joebmz98/DCLK/assets/DCLK_back_panel_BW_125x63mm_1200dpi.png

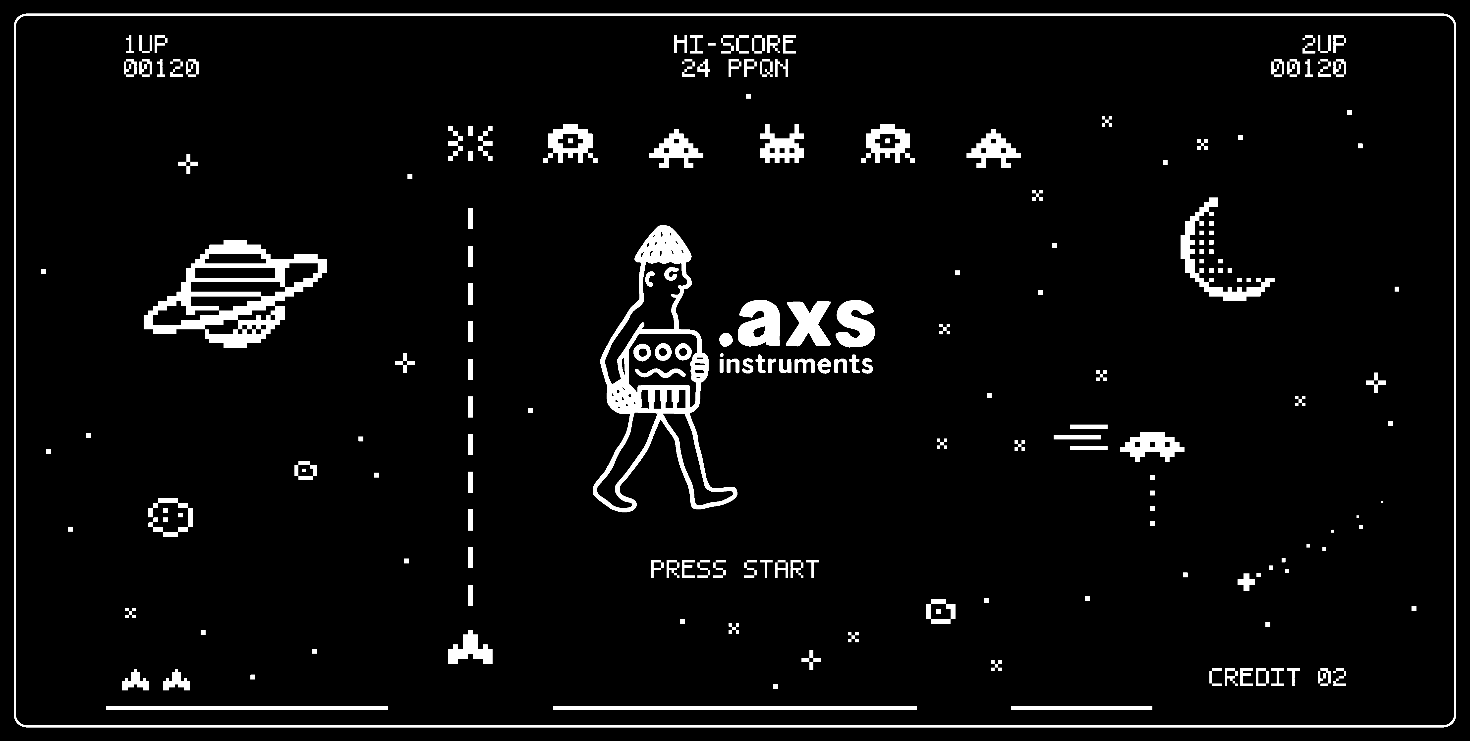
assets/DCLK_back_panel_BW_125x63mm_1200dpi.png
