joebmz98/DCLK/assets/DCLK_panel_BW_125x63mm_1200dpi.png

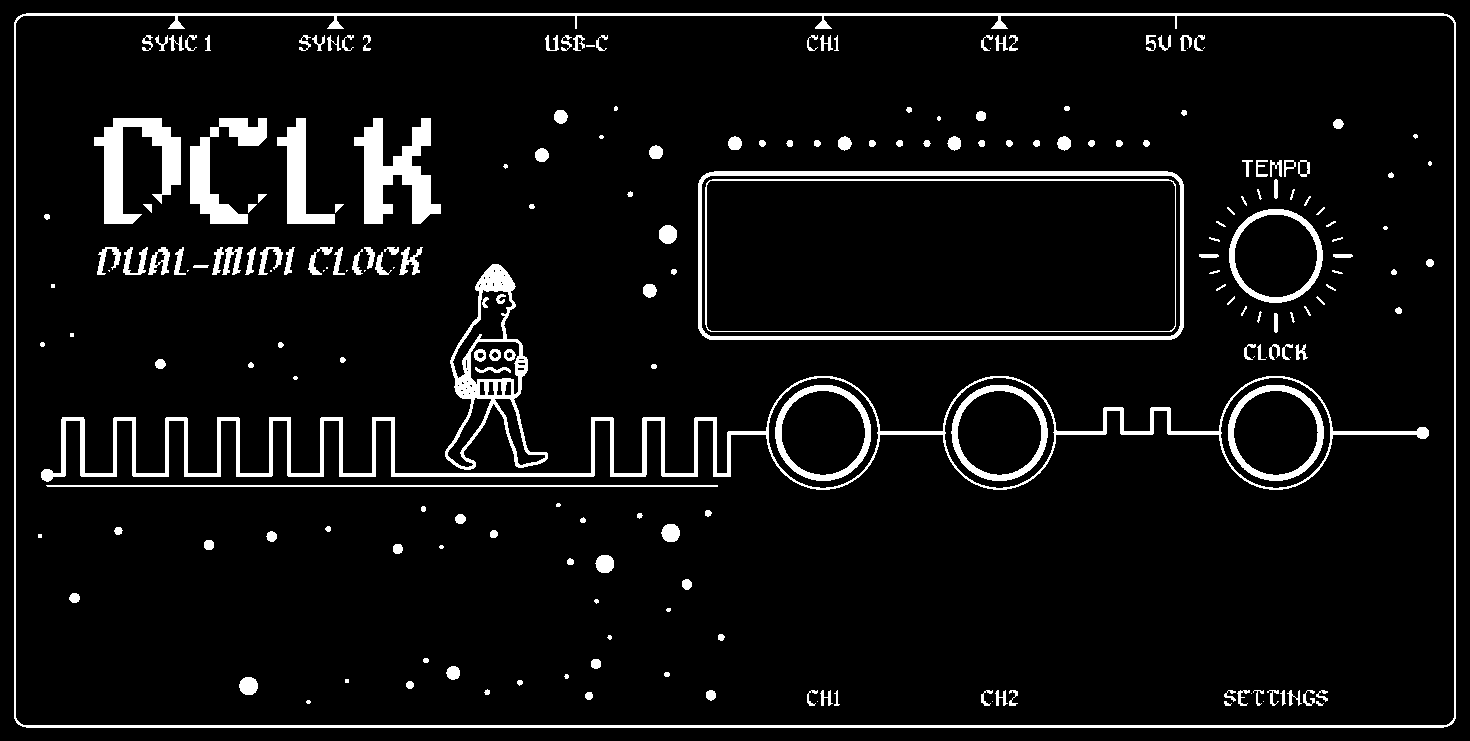
assets/DCLK_panel_BW_125x63mm_1200dpi.png
