joebmz98/DCLK/assets/Images/EDITS/DCLK_1.JPG

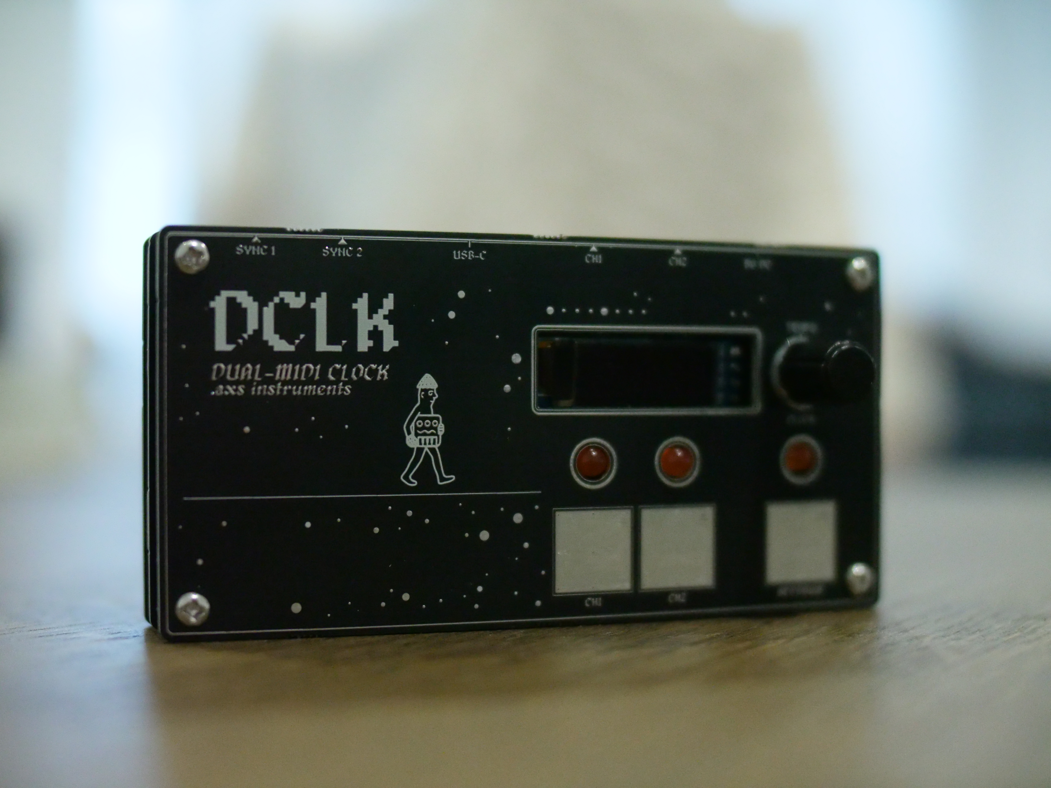
assets/Images/EDITS/DCLK_1.JPG
