joebmz98/DCLK/assets/Images/EDITS/DCLK_2.JPG

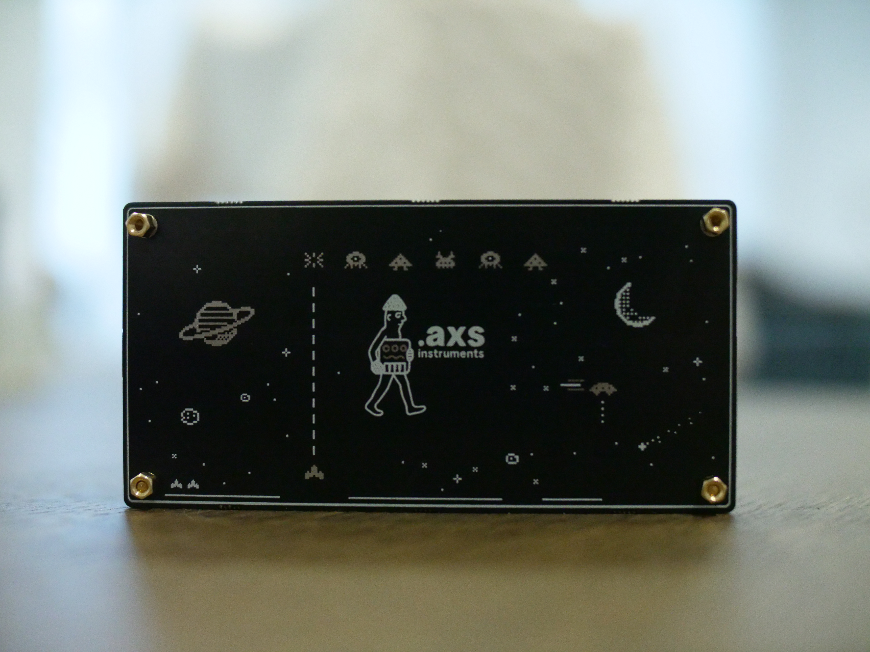
assets/Images/EDITS/DCLK_2.JPG
