joebmz98/DCLK/assets/Images/EDITS/DCLK_3.JPG

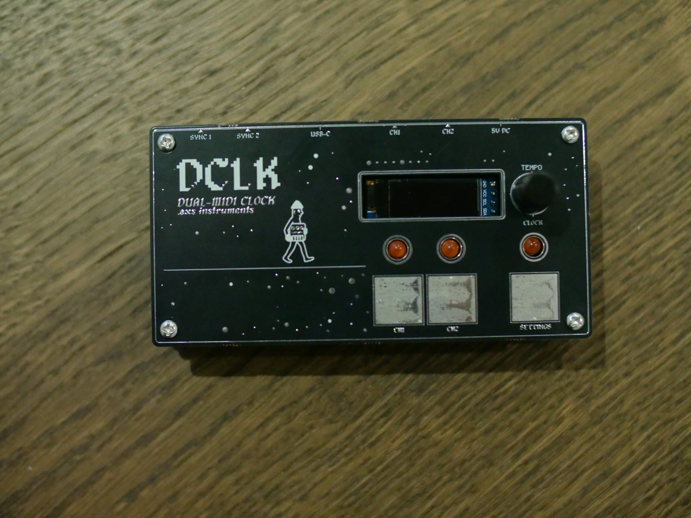
assets/Images/EDITS/DCLK_3.JPG
