joebmz98/DCLK/assets/Images/EDITS/DCLK_4.JPG

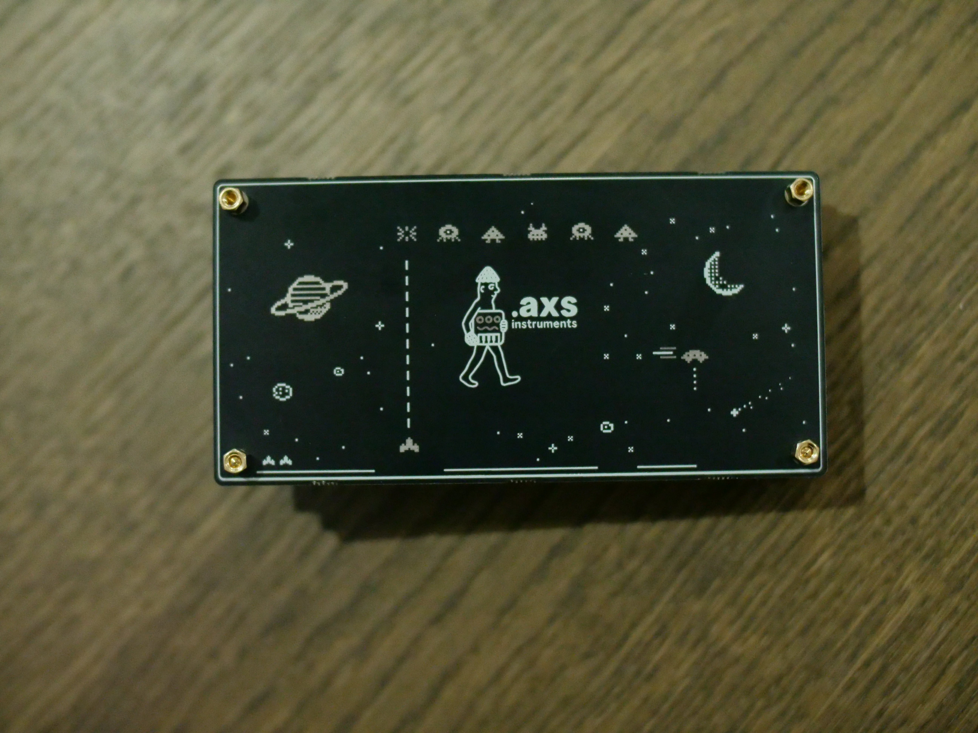
assets/Images/EDITS/DCLK_4.JPG
