joebmz98/DCLK/assets/Images/EDITS/DCLK_5.JPG

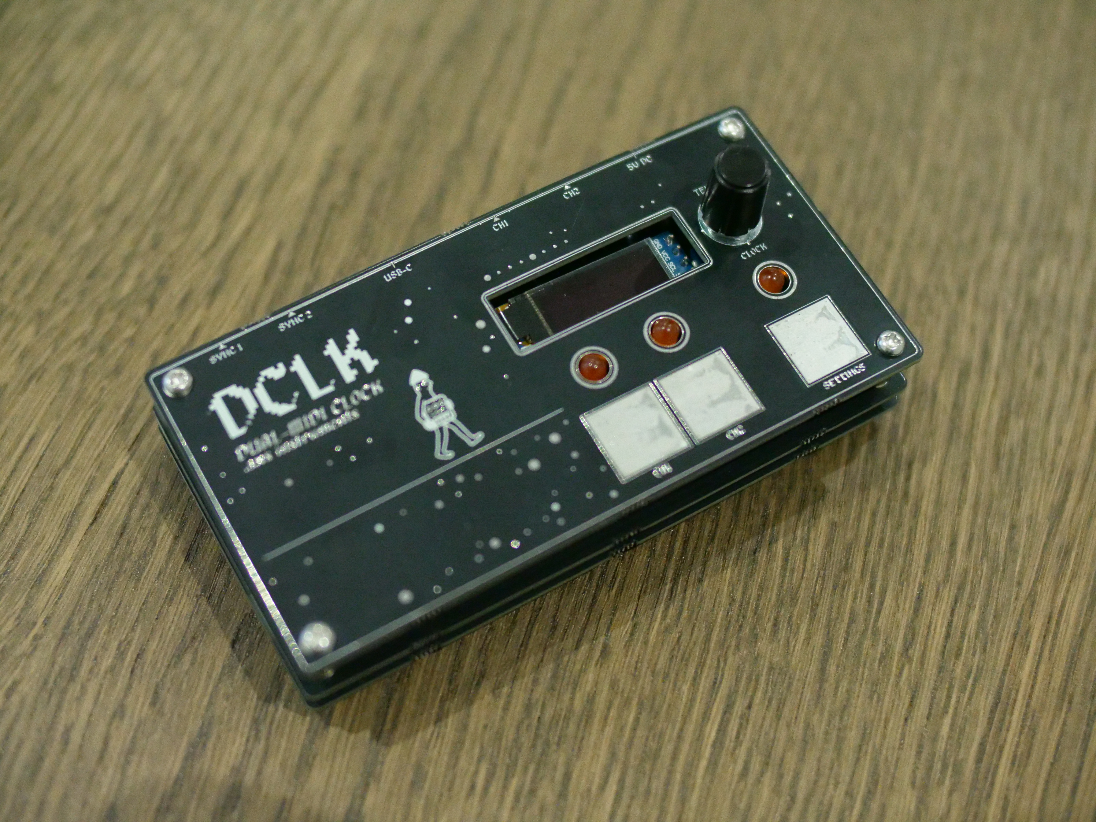
assets/Images/EDITS/DCLK_5.JPG
