joebmz98/DCLK/assets/KiCad Images/DCLK-MIDI-Clock-Schematic.png

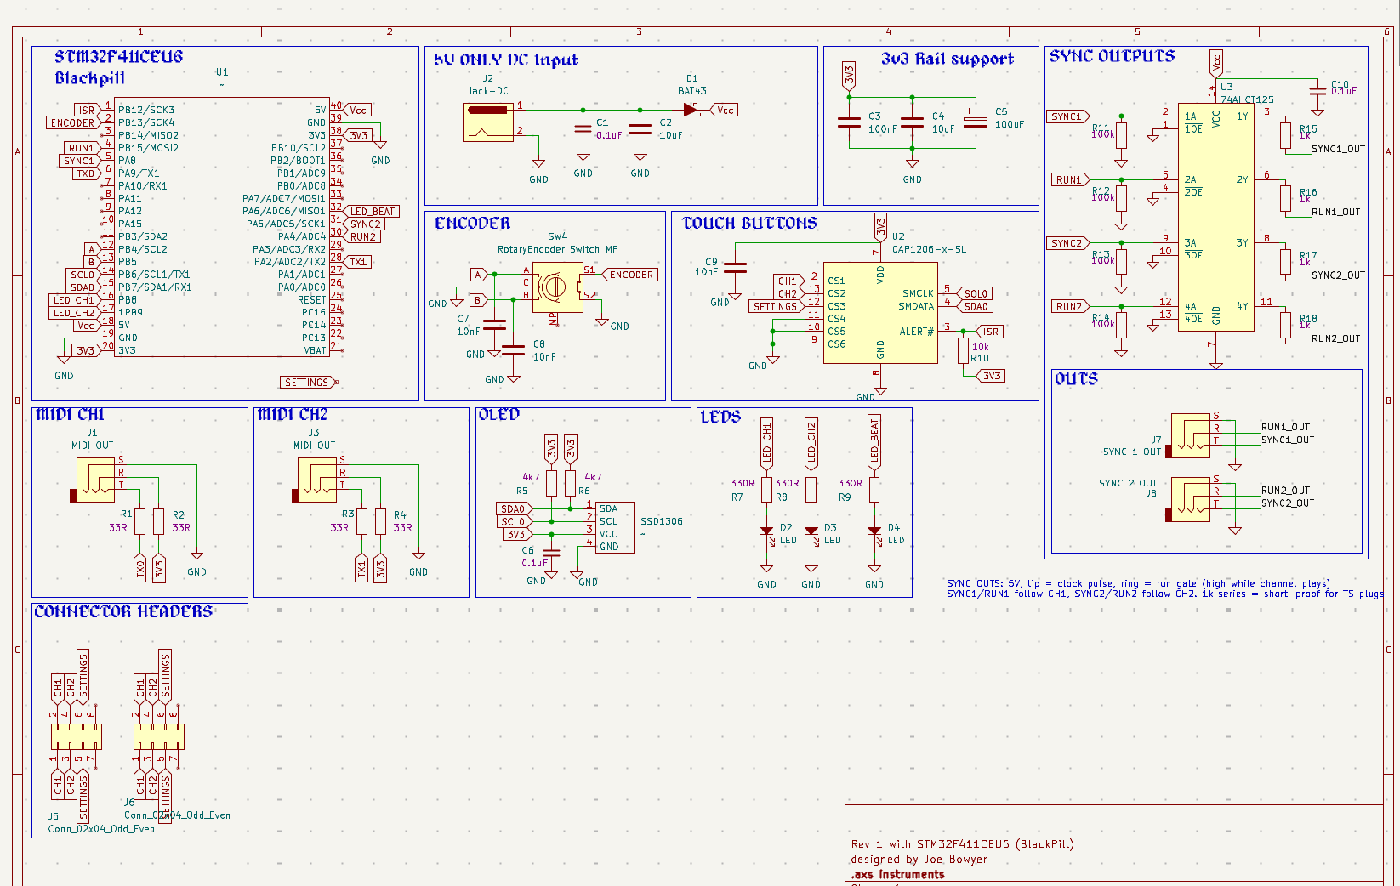
assets/KiCad Images/DCLK-MIDI-Clock-Schematic.png
