joebmz98/DCLK/assets/KiCad Images/DCLK-MIDI-Clock_bottom.png

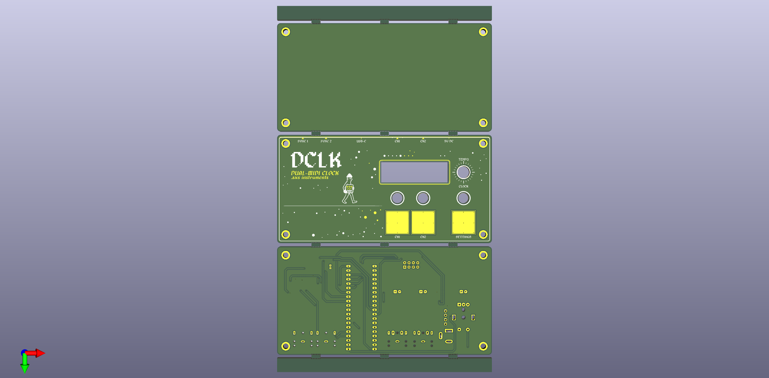
assets/KiCad Images/DCLK-MIDI-Clock_bottom.png
