joebmz98/DCLK/assets/KiCad Images/DCLK-MIDI-Clock_top.png

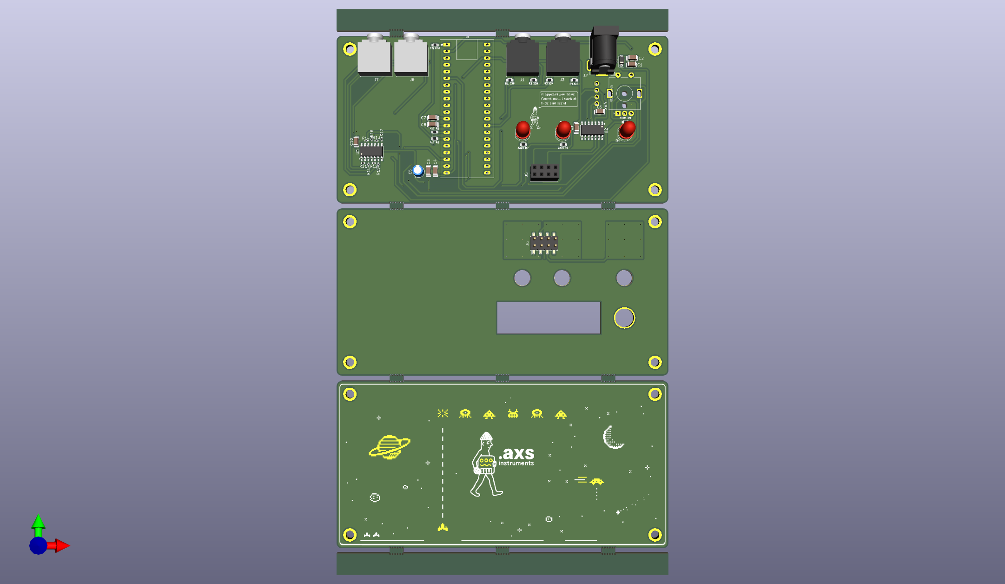
assets/KiCad Images/DCLK-MIDI-Clock_top.png
