joebmz98/DCLK/assets/KiCad Images/Screenshot 2026-10-31 at 09.25.36.png

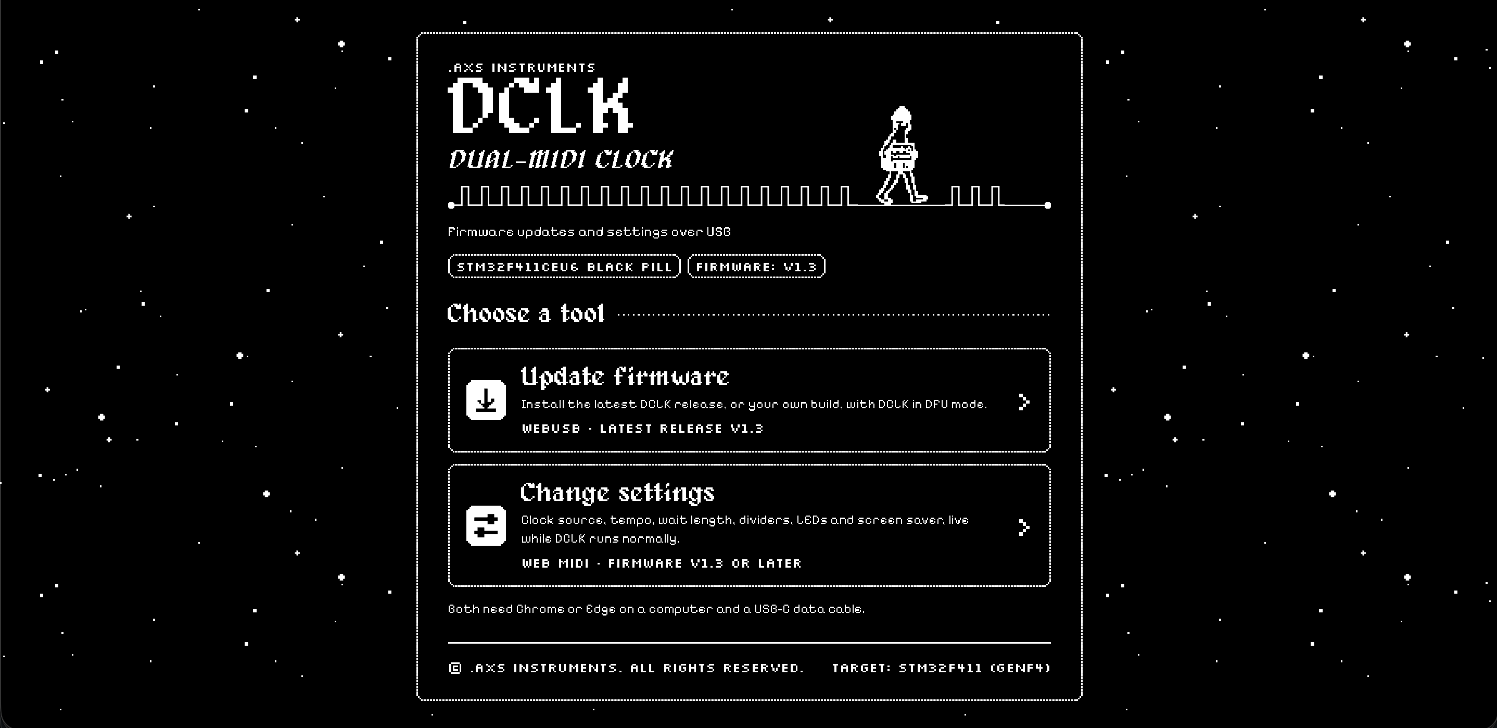
assets/KiCad Images/Screenshot 2026-10-31 at 09.25.36.png
