joebmz98/DCLK/assets/Polarity_marking_center_positive.png

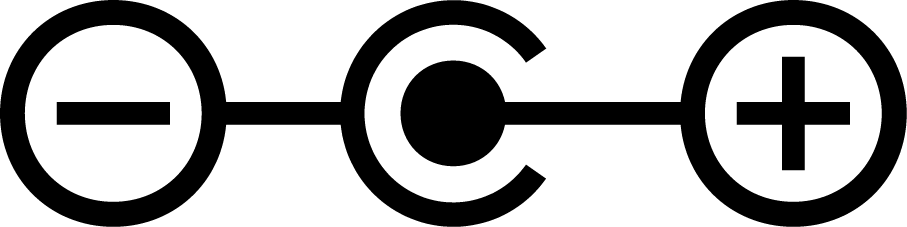
assets/Polarity_marking_center_positive.png
