joebmz98/DCLK/build/DCLK-MIDI-Clock/production/DCLK_bom.csv

Designator | Footprint | Quantity | Value | LCSC Part #
C1, C10, C3, C6 | 1206 | 4 | 100nF | C24497
C2, C4 | 1206 | 2 | 10uF | C13585
C5 | CP_Radial_D4.0mm_P1.50mm | 1 | 100uF
C7, C8, C9 | 1206 | 3 | 10nF | C1846
D1 | D_SOD-123 | 1 | BAT43 | C19167
D2, D3, D4 | LED_D5.0mm | 3 | LED
J1, J3 | Jack_3.5mm_CUI_SJ1-3525N_Horizontal_edit | 2 | MIDI OUT
J2 | BarrelJack_GCT_DCJ200-10-A_Horizontal | 1 | Jack-DC
J5 | PinSocket_2x04_P2.54mm_Vertical | 1 | Conn_02x04_Odd_Even | C54907661
J6 | PinHeader_2x04_P2.54mm_Vertical_SMD | 1 | Conn_02x04_Odd_Even | C41397153
J7 | PJ307-TRS-SOCKET | 1 | SYNC 1 OUT
J8 | PJ307-TRS-SOCKET | 1 | SYNC 2 OUT
R1, R2, R3, R4 | R_0603 | 4 | 33R | C23140
R10 | R_0603 | 1 | 10k | C15401
R11, R12, R13, R14 | 0402 | 4 | 100k | C25530
R15, R16, R17, R18 | 0402 | 4 | 1k | C11702
R5, R6 | R_0603 | 2 | 4k7 | C23162
R7, R8, R9 | R_0603 | 3 | 330R | C22104
SSD1306 | SSD1306-128x32 | 1 | ~
SW4 | RotaryEncoder_Alps_EC11E-Switch_Vertical_H20mm_MountingHoles | 1 | RotaryEncoder_Switch_MP
U1 | Z_module_black_pill_STM32F411 | 1 | ~
U2 | SOIC-14_3.9x8.7mm_P1.27mm | 1 | CAP1206-x-SL | C2652106
U3 | SOIC-14_3.9x8.7mm_P1.27mm | 1 | 74AHCT125 | C155176
