joebmz98/DCLK/build/DCLK-MIDI-Clock/DCLK-MIDI-Clock.kicad_pcb

## KiCad design build/DCLK-MIDI-Clock/DCLK-MIDI-Clock.kicad_pcb (2026-10-29)

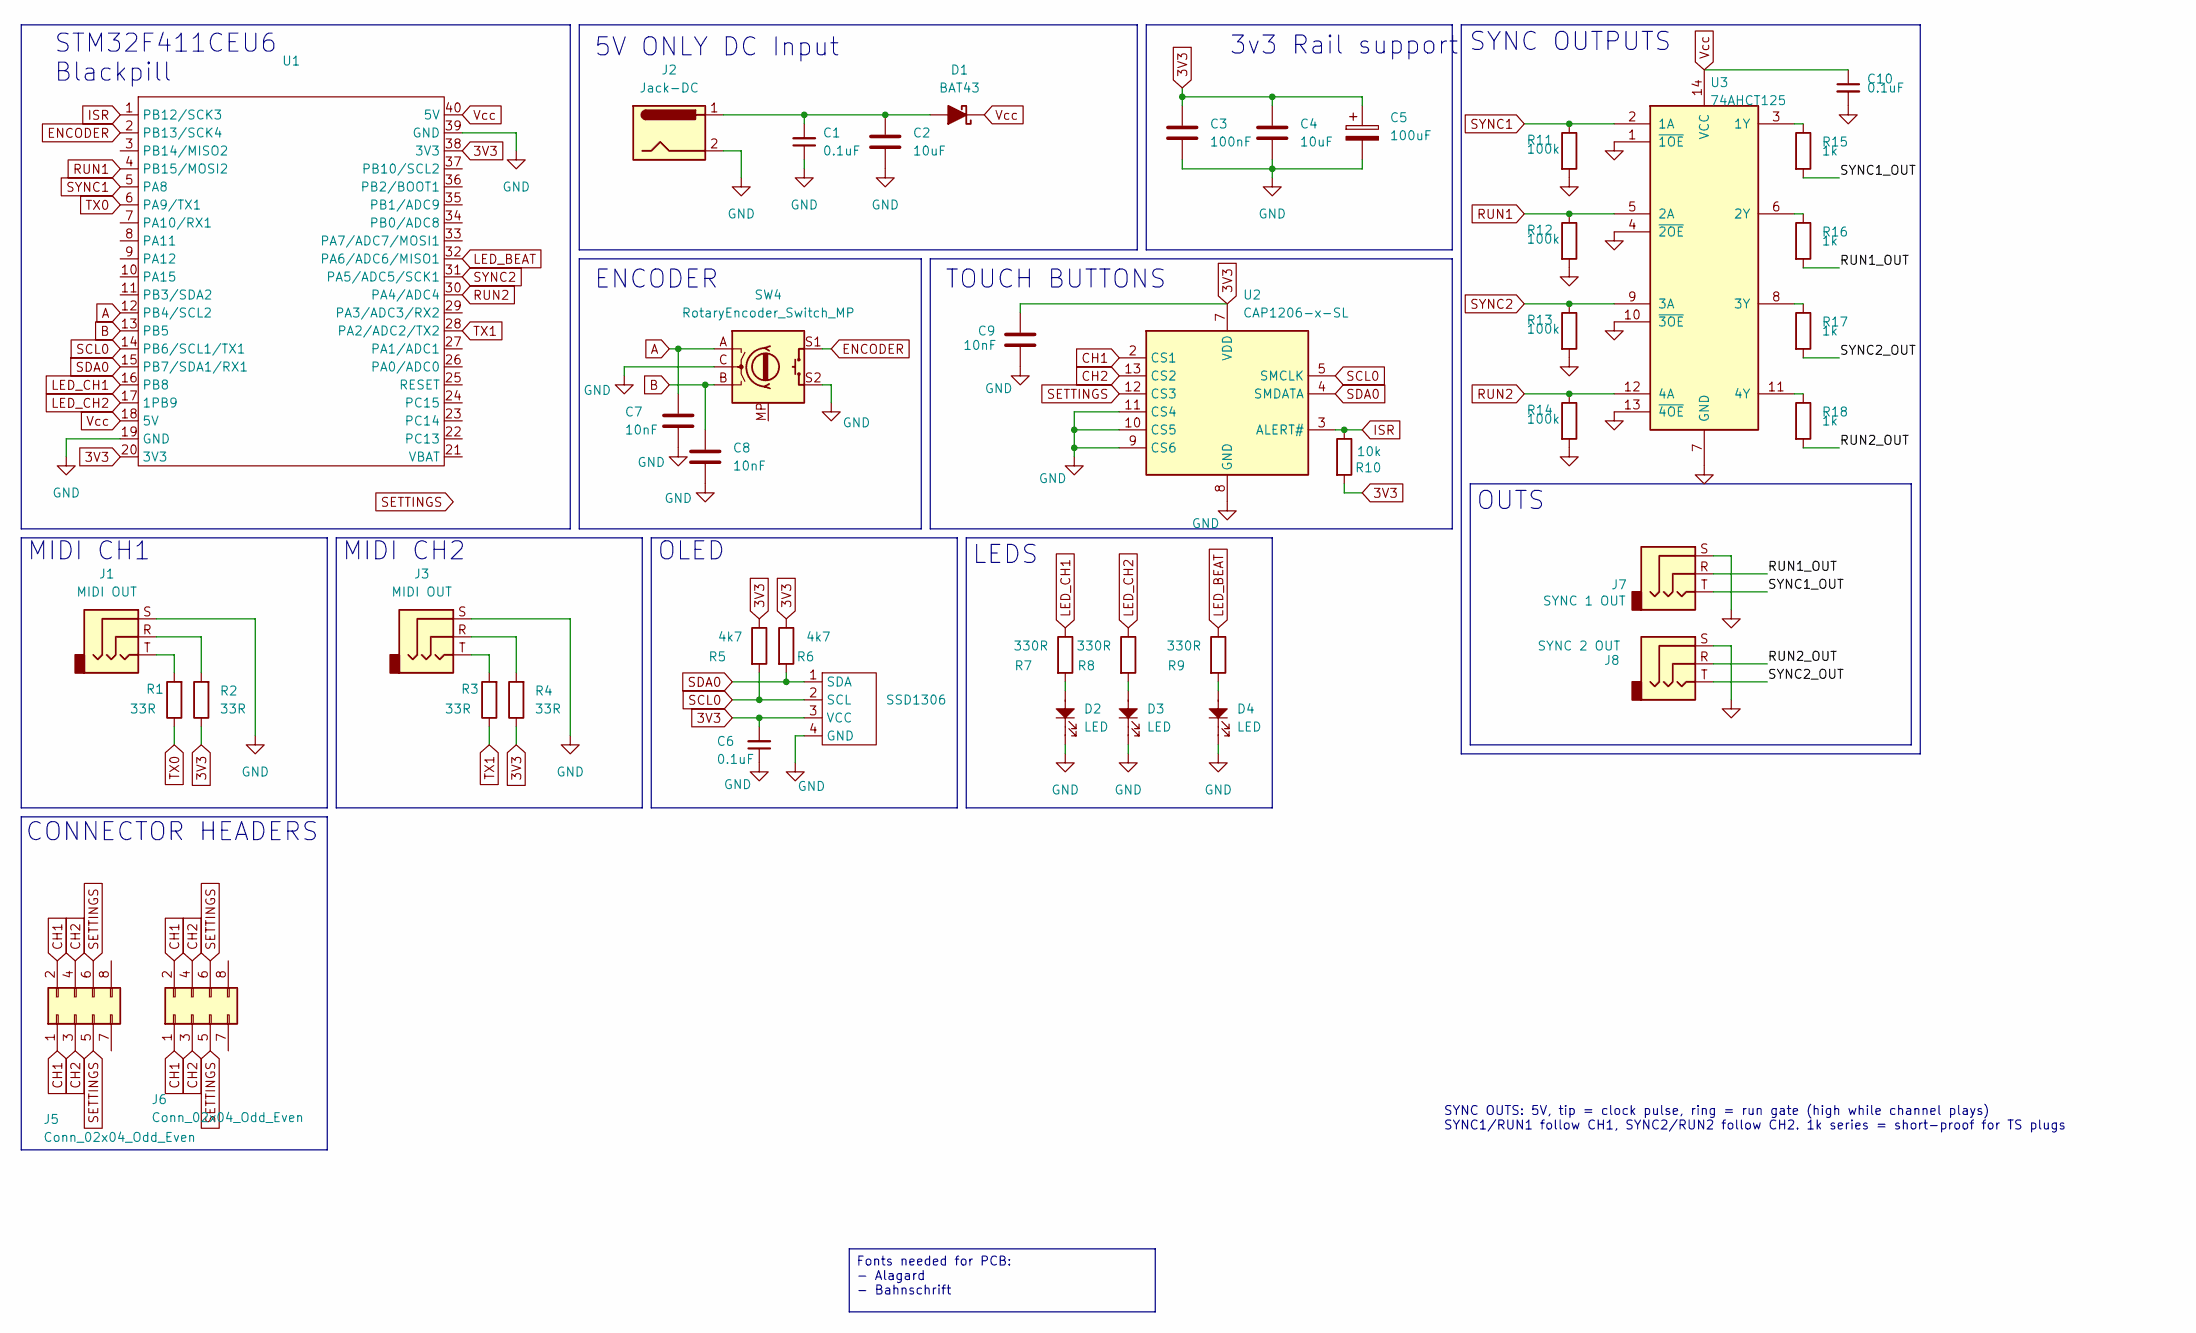
[picture p15: schematic DCLK-MIDI-Clock.kicad_sch, DCLK]

Parts:
C1, C6, C10: 100nF; C_1206_3216Metric; LCSC Part # C24497
C2, C4: 10uF; C_1206_3216Metric_Pad1.33x1.80mm_HandSolder; LCSC Part # C13585
C3: 100nF; C_1206_3216Metric_Pad1.33x1.80mm_HandSolder; LCSC Part # C24497
C5: 100uF; CP_Radial_D4.0mm_P1.50mm
C7, C8, C9: 10nF; C_1206_3216Metric_Pad1.33x1.80mm_HandSolder; LCSC Part # C1846
D1: BAT43; D_SOD-123; LCSC Part # C19167
D2, D3, D4: LED; LED_D5.0mm
J1, J3: MIDI OUT; Jack_3.5mm_CUI_SJ1-3525N_Horizontal_edit
J2: Jack-DC; BarrelJack_GCT_DCJ200-10-A_Horizontal
J5: Conn_02x04_Odd_Even; PinSocket_2x04_P2.54mm_Vertical; LCSC Part # C54907661
J6: Conn_02x04_Odd_Even; PinHeader_2x04_P2.54mm_Vertical_SMD; LCSC Part # C41397153
J7: SYNC 1 OUT; PJ307-TRS-SOCKET
J8: SYNC 2 OUT; PJ307-TRS-SOCKET
R1, R2, R3, R4: 33R; R_0603; LCSC Part # C23140
R5, R6: 4k7; R_0603; LCSC Part # C23162
R7, R8, R9: 330R; R_0603; LCSC Part # C22104
R10: 10k; R_0603; LCSC Part # C15401
R11, R12, R13, R14: 100k; R_0402_1005Metric; LCSC Part # C25530
R15, R16, R17, R18: 1k; R_0402_1005Metric; LCSC Part # C11702
SSD1306: SSD1306-128x32
SW4: RotaryEncoder_Switch_MP; RotaryEncoder_Alps_EC11E-Switch_Vertical_H20mm_MountingHoles
U1: Z_module_black_pill_STM32F411
U2: CAP1206-x-SL; SOIC-14_3.9x8.7mm_P1.27mm; LCSC Part # C2652106
U3: 74AHCT125; SOIC-14_3.9x8.7mm_P1.27mm; LCSC Part # C155176

Connections:
3V3: C3.1, C4.1, C5.1, C6.2, C9.2, R2.1, R4.1, R5.1, R6.1, R10.2, SSD1306.3 (VCC), U1.20 (3V3), U1.38 (3V3), U2.7 (VDD)
/RUN1_OUT: J7.R, R16.2
/RUN2_OUT: J8.R, R18.2
/SYNC1_OUT: J7.T, R15.2
/SYNC2_OUT: J8.T, R17.2
A: C7.1, SW4.A, U1.12 (PB4/SCL2)
B: C8.1, SW4.B, U1.13 (PB5)
CH1: J5.1, J5.2, J6.1, J6.2, U2.2 (CS1)
CH2: J5.3, J5.4, J6.3, J6.4, U2.13 (CS2)
ENCODER: SW4.S1, U1.2 (PB13/SCK4)
GND: C1.1, C2.2, C3.2, C4.2, C5.2, C6.1, C7.2, C8.2, C9.1, C10.2, D2.1, D3.1, D4.1, J1.S, J2.2, J3.S, J7.S, J8.S, R11.2, R12.2, R13.2, R14.2, SSD1306.4 (GND), SW4.C, SW4.S2, U1.19 (GND), U1.39 (GND), U2.8 (GND), U2.9 (CS6), U2.10 (CS5), U2.11 (CS4), U3.1 (~1OE), U3.4 (~2OE), U3.7 (GND), U3.10 (~3OE), U3.13 (~4OE)
ISR: R10.1, U1.1 (PB12/SCK3), U2.3 (ALERT#)
LED_BEAT: R9.1, U1.32 (PA6/ADC6/MISO1)
LED_CH1: R7.1, U1.16 (PB8)
LED_CH2: R8.1, U1.17 (1PB9)
unnamed: C1.2, C2.1, D1.2 (A), J2.1
unnamed: D2.2, R7.2
unnamed: D3.2, R8.2
unnamed: D4.2, R9.2
unnamed: J1.R, R2.2
unnamed: J1.T, R1.2
unnamed: J3.R, R4.2
unnamed: J3.T, R3.2
unnamed: R15.1, U3.3 (1Y)
unnamed: R16.1, U3.6 (2Y)
unnamed: R17.1, U3.8 (3Y)
unnamed: R18.1, U3.11 (4Y)
RUN1: R12.1, U1.4 (PB15/MOSI2), U3.5 (2A)
RUN2: R14.1, U1.30 (PA4/ADC4), U3.12 (4A)
SCL0: R5.2, SSD1306.2 (SCL), U1.14 (PB6/SCL1/TX1), U2.5 (SMCLK)
SDA0: R6.2, SSD1306.1 (SDA), U1.15 (PB7/SDA1/RX1), U2.4 (SMDATA)
SETTINGS: J5.5, J5.6, J6.5, J6.6, U2.12 (CS3)
SYNC1: R11.1, U1.5 (PA8), U3.2 (1A)
SYNC2: R13.1, U1.31 (PA5/ADC5/SCK1), U3.9 (3A)
TX0: R1.1, U1.6 (PA9/TX1)
TX1: R3.1, U1.28 (PA2/ADC2/TX2)
Vcc: C10.1, D1.1 (K), U1.18 (5V), U1.40 (5V), U3.14 (VCC)

Notes on the sheet:
SYNC OUTS: 5V, tip = clock pulse, ring = run gate (high while channel plays) SYNC1/RUN1 follow CH1, SYNC2/RUN2 follow CH2. 1k series = short-proof for TS plugs
OUTS
STM32F411CEU6 Blackpill
5V ONLY DC Input
TOUCH BUTTONS
3v3 Rail support
ENCODER
MIDI CH2
SYNC OUTPUTS
LEDS
MIDI CH1
CONNECTOR HEADERS
OLED
Fonts needed for PCB: - Alagard - Bahnschrift

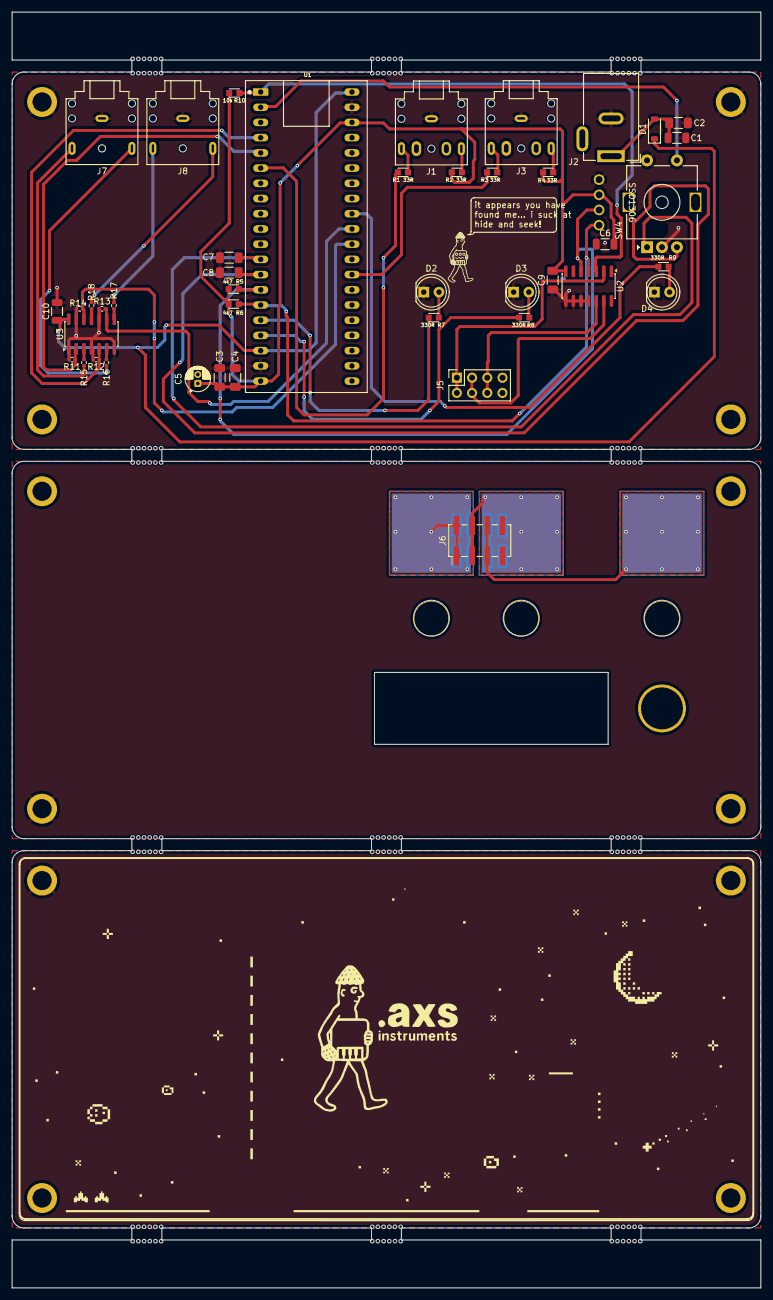
[picture p16: board build/DCLK-MIDI-Clock/DCLK-MIDI-Clock.kicad_pcb from above]

Board: 2 copper layers, 125.0 x 213.0 mm, 56 parts (0 on the bottom side), 37 nets.

Other parts of the board:
MB**: MouseBite_Tab; MouseBite_Tab_5mm_Gap2mm
MB**#2, MB**#3, MB**#4, MB**#5, MB**#6, MB**#7, MB**#8, MB**#9, MB**#10, MB**#11, MB**#12: MouseBite_Tab; MouseBite_Tab_5mm_Gap2mm
