joebmz98/DCLK/DCLK-MIDI-Clock/DCLK-MIDI-Clock.kicad_pcb

## KiCad design DCLK-MIDI-Clock/DCLK-MIDI-Clock.kicad_pcb (2026-10-22, an earlier design)

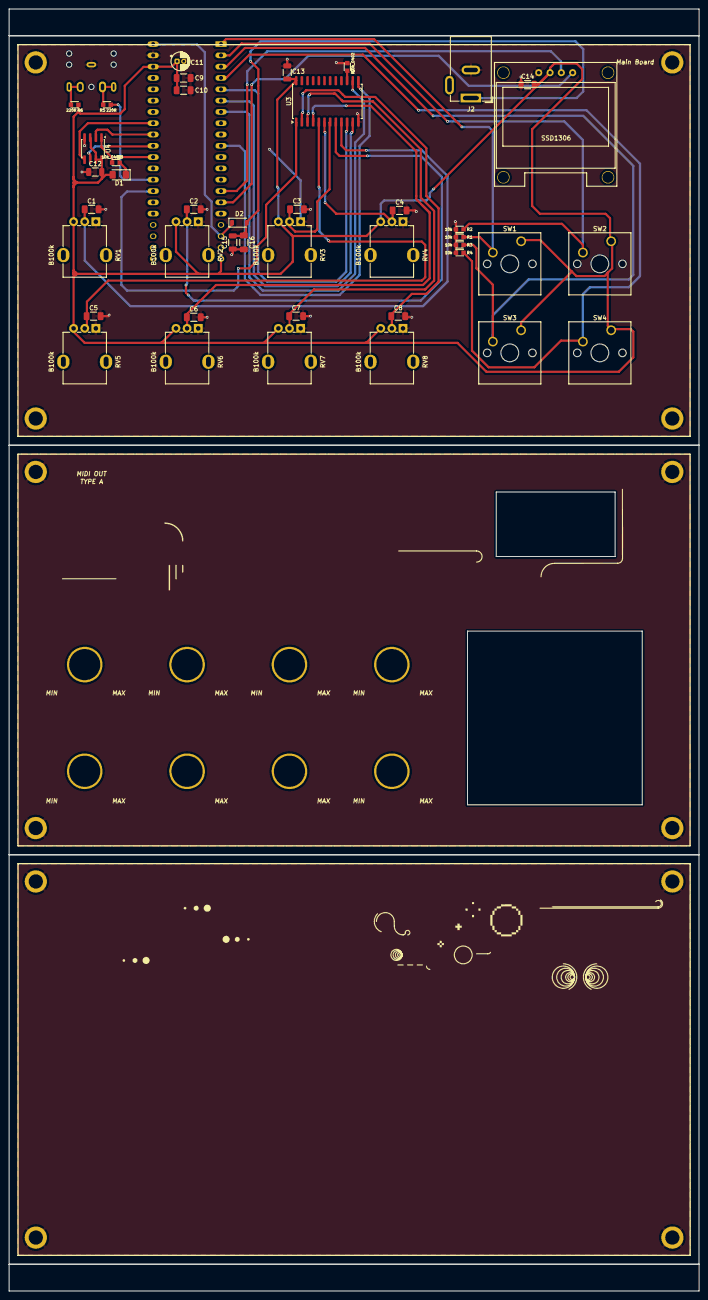
[picture p17: board DCLK-MIDI-Clock/DCLK-MIDI-Clock.kicad_pcb from above]

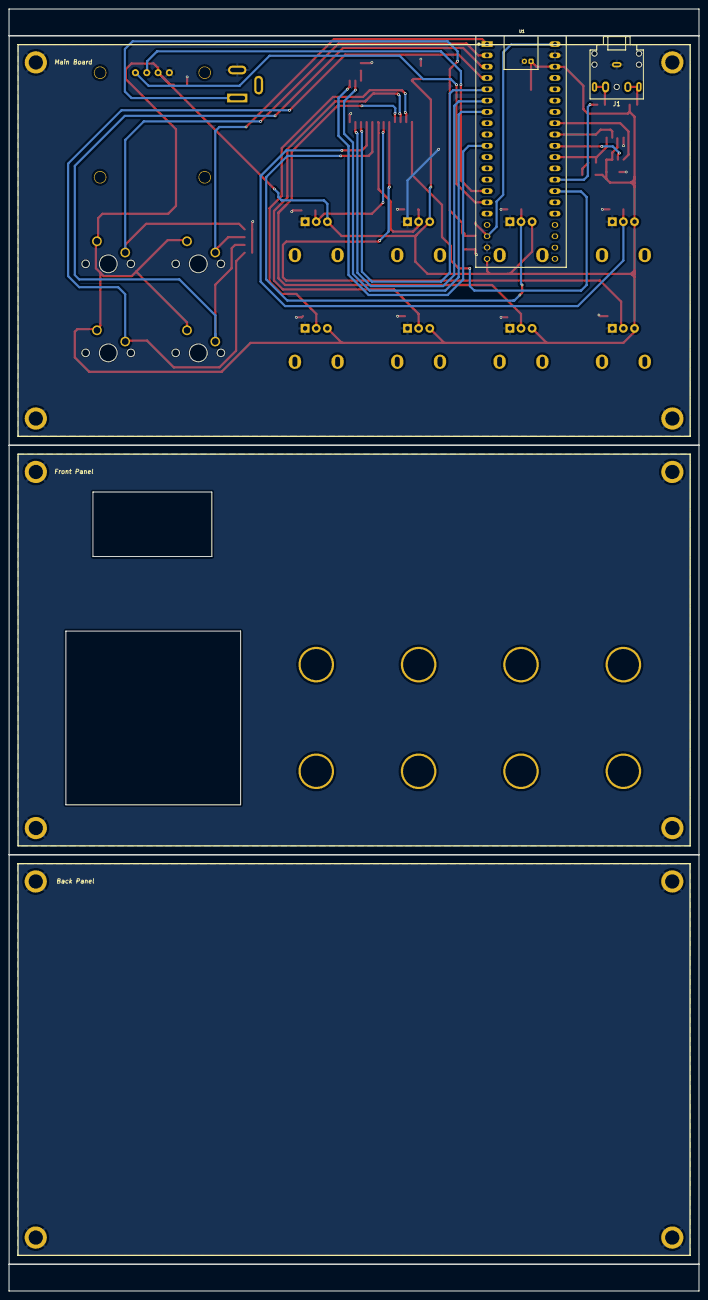
[picture p18: board DCLK-MIDI-Clock/DCLK-MIDI-Clock.kicad_pcb from below]

Board: 2 copper layers, 155.0 x 288.0 mm, 44 parts (3 on the bottom side), 32 nets.

Parts:
C1, C2, C3, C4, C5, C6, C7, C8: C_Generic; C_1206_3216Metric_Pad1.33x1.80mm_HandSolder
C9: 100nF; C_1206_3216Metric_Pad1.33x1.80mm_HandSolder
C10, C16: 10uF; C_1206_3216Metric_Pad1.33x1.80mm_HandSolder
C11: 100uF; CP_Radial_D4.0mm_P1.50mm
C12, C13, C14, C15: 100nF_0603_16V; C_1206_3216Metric
D1: LED; LED_1206_3216Metric_Pad1.42x1.75mm_HandSolder
D2: BAT43; D_SOD-123
J1: MIDI OUT; Jack_3.5mm_CUI_SJ1-3525N_Horizontal_edit
J2: Jack-DC; BarrelJack_GCT_DCJ200-10-A_Horizontal
R1, R2, R3, R4: 10k; R_0603
R5, R6: 220R; R_0603
R7, R8: 10k_0402; R_0603
RV1, RV2, RV3, RV4, RV5, RV6, RV7, RV8: B100k; Potentiometer_RV09_BigPads
SSD1306: SSD1306_OLED_Module
SW1: ASSIGN; SW_Cherry_MX_1.00u_PCB
SW2: ENTER; SW_Cherry_MX_1.00u_PCB
SW3: PREV; SW_Cherry_MX_1.00u_PCB
SW4: NEXT; SW_Cherry_MX_1.00u_PCB
U1: Z_module_black_pill_STM32F411
U3: CD74HC4067M; SOIC-24W_7.5x15.4mm_P1.27mm
U4: W25Q64; SOIC-8_3.9x4.9mm_P1.27mm

Connections:
3V3: C9.1, C10.1, C11.1, C12.2, C13.1, C14.2, D1.2 (A), R6.1, RV1.3, RV2.3, RV3.3, RV4.3, RV5.3, RV6.3, RV7.3, RV8.3, SSD1306.3 (VCC), SW1.1 (A), SW2.1 (A), SW3.1 (A), SW4.1 (A), U1.20 (3V3), U1.38 (3V3), U3.24 (VCC), U4.3 (WP), U4.7 (HOLD), U4.8 (VCC)
ASSIGN: R1.1, SW1.2 (B), U1.1 (PB12/SCK3)
CLK: U1.31 (PA5/ADC5/SCK1), U4.6 (CLK)
CS: R8.1, U1.30 (PA4/ADC4), U4.1 (CS)
ENTER: R2.1, SW2.2 (B), U1.2 (PB13/SCK4)
GND: C1.2, C2.2, C3.2, C4.2, C5.2, C6.2, C7.2, C8.2, C9.2, C10.2, C11.2, C12.1, C13.2, C14.1, C15.1, C16.2, J1.S, J2.2, R1.2, R2.2, R3.2, R4.2, R7.2, RV1.1, RV2.1, RV3.1, RV4.1, RV5.1, RV6.1, RV7.1, RV8.1, SSD1306.4 (GND), U1.19 (GND), U1.39 (GND), U3.12 (GND), U4.4 (GND)
MISO: U1.32 (PA6/ADC6/MISO1), U4.2 (MISO/DO)
MOSI: U1.33 (PA7/ADC7/MOSI1), U4.5 (MOSI/DI)
NEXT: R4.1, SW4.2 (B), U1.4 (PB15/MOSI2)
unnamed: D1.1 (K), R8.2
unnamed: C15.2, C16.1, D2.2 (A), J2.1
unnamed: J1.R, R6.2
unnamed: J1.T, R5.2
unnamed: R7.1, U3.15 (~E)
PREV: R3.1, SW3.2 (B), U1.3 (PB14/MISO2)
S0: U1.5 (PA8), U3.10 (S0)
S1: U1.6 (PA9/TX1), U3.11 (S1)
S2: U1.7 (PA10/RX1), U3.14 (S2)
S3: U1.10 (PA15), U3.13 (S3)
SCL0: SSD1306.2 (SCL), U1.14 (PB6/SCL1/TX1)
SDA0: SSD1306.1 (SDA), U1.15 (PB7/SDA1/RX1)
SIG: U1.27 (PA1/ADC1), U3.1 (COM)
TX0: R5.1, U1.28 (PA2/ADC2/TX2)
Vcc: D2.1 (K), U1.18 (5V), U1.40 (5V)
pot1: C1.1, RV1.2, U3.9 (I0)
pot2: C2.1, RV2.2, U3.8 (I1)
pot3: C3.1, RV3.2, U3.7 (I2)
pot4: C4.1, RV4.2, U3.6 (I3)
pot5: C5.1, RV5.2, U3.5 (I4)
pot6: C6.1, RV6.2, U3.4 (I5)
pot7: C7.1, RV7.2, U3.3 (I6)
pot8: C8.1, RV8.2, U3.2 (I7)
