joebmz98/DCLK/(commit log)

2026-10-22 pcb rev1
2026-10-22 pcb rev2
2026-10-23 PCB Update
    - panel designs
    - production files
2026-10-23 pcb update
2026-10-23 PCB update
    -Added 2x Sync Output
    -Moved 5V DC in
2026-10-23 sch and pcb tweaks
2026-10-24 Split panel edges at mouse-bite tabs so boards join only at the tabs
    Board edges at y=26/89/91/154/156/219 and both rail rectangles are broken
    at x=38-43, 78-83, 118-123 to meet the tab footprints' bridge lines.
    Outline is now one outer contour + 8 routed slots.
    Claude-Session: https://claude.ai/code/session_01XGX6wcyehYks8dMCrphrdY
2026-10-24 pcb mouse bites fix
2026-10-24 pcb design update
2026-10-28 pcb update
    -fixed oled positions
    - fixed resistor inconsistencies
2026-10-28 updated bom
2026-10-28 PCB Update with new Symbol fields
    - fixes BOM
2026-10-28 Add LCSC part numbers; clean C1/C6 footprint fields; remove J5 pin 7-8 track
    - 'LCSC Part #' field on all 32 JLC-assembled parts (schematic + PCB),
    numbers taken from DCLK_bom_jcl.xls; 100nF (C1/C3/C6/C10) = C24497 (1206)
    - Drop stale 0603 Part Number / JLCPCB ID / Manufacturer from C1/C6 footprints
    - Delete stray track shorting unused J5 pins 7 and 8
    - DCLK_bom.csv: LCSC column filled, mouse-bite tab row removed
    - DCLK_bom_jcl.xls: 100nF line labelled 1206
    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
2026-10-29 schematic update
2026-11-03 Firmware 1.4: CAP1206 touch pads, reversed encoder
    - CH1 / CH2 / Settings now come from the CAP1206 on the shared I2C bus
    (CS1/CS2/CS3, ALERT# on PB12) instead of GPIO buttons on PB0/PB1/PB14.
    Reads are in loop() context only, so they never interleave with the
    chunked OLED flush. ALERT# triggers an immediate read, with a 20 ms
    backup poll. Status is read before clearing INT so quick taps aren't
    lost. Auto-repeat and multi-touch blocking are off so CH1 + CH2 can be
    touched together. The chip is re-initialised if it stops answering.
    - Encoder direction reversed (ENC_DIR = -1).
    - MONITOR screen shows T:Y/N for the touch controller.
    - README pin table updated for the final PCB.
    Co-A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
2026-11-04 Firmware 1.5: enter DFU mode from the menu or over USB
    - Settings > UPDATE restarts DCLK into the STM32 ROM DFU bootloader
    (encoder push confirms, SETTINGS cancels).
    - SysEx 07 44 46 55 ("DFU") does the same from the web flasher; DCLK
    replies 47 first.
    - Before restarting: clocks stopped cleanly, unsaved settings written,
    LEDs off, "DFU READY" left on the OLED (it keeps the picture through
    the reset).
    - A one-shot flag in RTC backup register DR5 survives the reset; setup()
    checks it first and jumps to 0x1FFF0000 before any peripheral starts.
    PA10 (USART1_RX, unused) is pulled up so the bootloader picks USB.
    README: update-mode steps and the UPDATE menu.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
2026-11-04 Firmware 1.6: drive the analogue sync outputs
    The sync hardware (74AHCT125, J7/J8) was in place but no firmware set up
    or drove its inputs, so the 100k pull-downs held every output at 0 V.
    - SYNC1 PA8 / RUN1 PB15 follow CH1, SYNC2 PA5 / RUN2 PA4 follow CH2
    - Tip: clock pulse at SYNC_PPQN (2) per beat after the channel divider,
    10 ms wide, capped at 50% duty; TIM5 ends the pulses
    - Ring: run gate, high while the channel plays, dropped on every stop
    - Works in USB clock mode using the measured tempo
    - README: v1.6, sync outputs, pins
    Claude-Session: https://claude.ai/code/session_01PVTBgvYsQAEvCK85h8cW3e
2026-11-05 Firmware 1.6.2: CH1 / CH2 play tabs on the main screen
    - Tabs across the top (rows 0-5): white with black text while the output
    plays, black with white text when stopped
    - Tempo moved down to rows 9-28; beat bars are now 1 px along the bottom
    with the current beat raised to 2 px
    - README: v1.6.2, main screen description
    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
2026-11-07 Firmware 1.6.3: beat bars and BEAT LED follow the host
    In USB clock mode with HOST transport, the main-screen beat bars and the
    BEAT LED now move with the host's beat while it plays, even when both
    outputs are off. Internal clock and USB FREE behave as before (they only
    move while an output runs). README: v1.6.3.
    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
